Gmanmodz/RVL-Power-Management-System/Wii PMS BOM.xlsx

Wii Power Management System | Total: | 29.946
Reference | Description | Price | Manufacturer P/N | Vender | Link
U1, U2, U4, U5 | IC REG BUCK ADJ 4A SYNC 16QFN | 7.48 | TLV62095RGTR | Digikey | https://www.digikey.com/product-detail/en/texas-instruments/TLV62095RGTR/296-46277-1-ND/7033452
U3 | TPS61232DRCR | 2.54 | TPS61232DRCR | Digikey | https://www.digikey.com/product-detail/en/texas-instruments/TPS61232DRCR/296-44498-1-ND/6110782
U6 | IC MCU 8BIT 7KB FLASH 16UQFN | 0.85 | PIC16F15324T-I/JQ | Digikey | https://www.digikey.com/product-detail/en/microchip-technology/PIC16F15324T-I-JQ/PIC16F15324T-I-JQCT-ND/7346310
U7 | BQ25895M | 3.36 | BQ25895MRTWR | Digikey | https://www.digikey.com/products/en?keywords=296-42447-1-ND%09
R1, R2, R8, R9 | RES SMD 160K OHM 1% 1/10W 0603 | 0.4 | RC0603FR-07160KL | Digikey | https://www.digikey.com/product-detail/en/yageo/RC0603FR-07160KL/311-160KHRCT-ND/729920
R3 | RES SMD 44.2K OHM 1% 1/10W 0603 | 0.1 | RC0603FR-0744K2L | Digikey | https://www.digikey.com/product-detail/en/yageo/RC0603FR-0744K2L/311-44.2KHRCT-ND/730188
R4 | RES SMD 510K OHM 1% 1/10W 0603 | 0.1 | RC0603FR-07510KL | Digikey | https://www.digikey.com/product-detail/en/yageo/RC0603FR-07510KL/311-510KHRCT-ND/730233
R5, R7, R13, R15, R17, R18, R19 | RES SMD 10K OHM 1% 1/10W 0603 | 0.7 | RC0603FR-0710KL | Digikey | https://www.digikey.com/product-detail/en/yageo/RC0603FR-0710KL/311-10.0KHRCT-ND/729827
R6, R10, R14 | RES 100 OHM 1% 1/10W 0603 | 0.3 | RMCF0603FT100R | Digikey | https://www.digikey.com/product-detail/en/stackpole-electronics-inc/RMCF0603FT100R/RMCF0603FT100RCT-ND/1942965
R11 | RES SMD 200K OHM 1% 1/10W 0603 | 0.1 | RC0603FR-07200KL | Digikey | https://www.digikey.com/product-detail/en/yageo/RC0603FR-07200KL/311-200KHRCT-ND/729991
R12 | RES SMD 75K OHM 1% 1/10W 0603 | 0.1 | RC0603FR-0775KL | Digikey | https://www.digikey.com/product-detail/en/yageo/RC0603FR-0775KL/311-75.0KHRCT-ND/730325
R16 | RES SMD 261 OHM 1% 1/10W 0603 | 0.1 | RC0603FR-07261RL | Digikey | https://www.digikey.com/product-detail/en/yageo/RC0603FR-07261RL/311-261HRCT-ND/730042
RN1 | RES ARRAY 4 RES 10K OHM 0804 | 0.1 | EXB-28V103JX | Digikey | https://www.digikey.com/product-detail/en/panasonic-electronic-components/EXB-28V103JX/Y7103CT-ND/256360
C1, C2, C3, C4, C5, C6, C7, C10, C11, C12, C13, C14, C15, C16, C19, C20 | CAP CER 22UF 6.3V X5R 0805 | 2.336 | CL21A226MQQNNNE | Digikey | https://www.digikey.com/product-detail/en/samsung-electro-mechanics/CL21A226MQQNNNE/1276-1100-1-ND/3889186
C8, C9, C17, C18 | CAP CER 10000PF 50V X7R 0603 | 0.4 | 06035C103KAT4A | Digikey | https://www.digikey.com/product-detail/en/avx-corporation/06035C103KAT4A/478-10055-1-ND/6564278
C21, C22 | CAP CER 1UF 25V X7R 0805 | 0.76 | GCM21BR71E105KA56L | Digikey | https://www.digikey.com/product-detail/en/murata-electronics-north-america/GCM21BR71E105KA56L/490-4785-1-ND/1641704
C23 | CAP CER 4.7UF 16V X5R 0603 | 0.29 | CL10A475KO8NNNC | Digikey | https://www.digikey.com/product-detail/en/samsung-electro-mechanics/CL10A475KO8NNNC/1276-1784-1-ND/3889870
C24 | CAP CER 0.047UF 25V X7R 0603 | 0.13 | C0603C473K3RACTU | Digikey | https://www.digikey.com/product-detail/en/kemet/C0603C473K3RACTU/399-7931-1-ND/3471654
C25, C26, C27, C29 | CAP CER 10UF 16V X5R 0805 | 0.68 | CL21A106KOQNNNG | Digikey | https://www.digikey.com/product-detail/en/samsung-electro-mechanics/CL21A106KOQNNNG/1276-6455-1-ND/5958083
L1, L2, L3, L4, L5 | FIXED IND 1UH 5.1A 27 MOHM SMD | 3.6 | MDWK4040T1R0MM | Digikey | https://www.digikey.com/product-detail/en/taiyo-yuden/MDWK4040T1R0MM/587-4447-1-ND/5880037
L6 | FIXED IND 2.2UH 8A 20 MOHM SMD | 0.89 | ASPI-0630HI-2R2M-T15 | Digikey | https://www.digikey.com/product-detail/en/abracon-llc/ASPI-0630HI-2R2M-T15/ASPI-0630HI-2R2M-T15CT-ND/3060148
Q1, Q2, Q3 | TRANS NPN 40V 0.2A SOT23 | 0.3 | MMBT3904-TP | Digikey | https://www.digikey.com/product-detail/en/micro-commercial-co/MMBT3904-TP/MMBT3904TPMSCT-ND/717395
TH1 | THERMISTOR NTC 10KOHM 3988K BEAD | 3.72 | B57861S0103A043 | Digikey | https://www.digikey.com/product-detail/en/epcos-tdk/B57861S0103A043/495-6714-ND/4945323
RGB led | LED RGB DIFFUSED CHIP SMD | 0.61 | LTST-C19HE1WT | Digikey | https://www.digikey.com/products/en?keywords=160-2162-1
