Gmanmodz/RVL-Power-Management-System/RVLPMS (OLD)/WiiPMS KiCAD files/Wii reg.kicad_pcb

## KiCad design RVLPMS (OLD)/WiiPMS KiCAD files/Wii reg.kicad_pcb (2020-04-27, an earlier design)

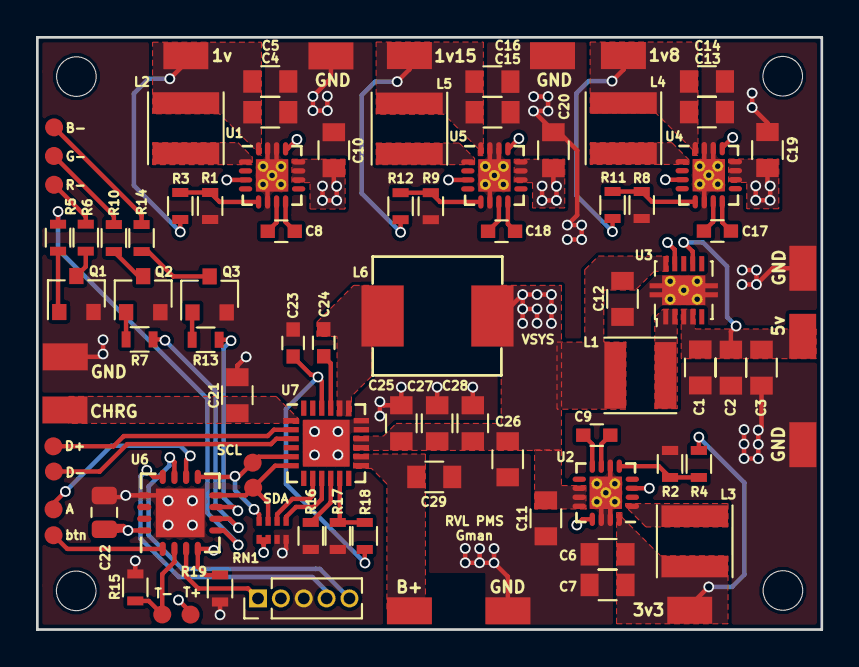
[picture p1: board Wii reg.kicad_pcb from above]

Board: 4 copper layers, 43.6 x 32.9 mm, 91 parts (0 on the bottom side), 56 nets.

Parts:
1v, 1v8, 1v15, 3v3, 5v: TEST_1P; TP2
B+: TEST_1P; TP2
C1, C2, C3, C4, C5, C6, C7, C10, C11, C12, C13, C14, C15, C16, C19, C20, C21, C25, C26, C27, C28, C29: C; C_0805
C8, C9, C17, C18, C23, C24: C; C_0603
C22: C; C_0805_2012Metric
CHRG: TEST_1P; TP2
GND: TEST_1P; TP2
GND#2, GND#3, GND#4, GND#5, GND#6: TEST_1P; TP2
J4, J5, J8, J11, J12, J14, J16, J17, J18, J24, J26: TEST_1P; TP1
J25: Conn_01x05; Pin_Header_Straight_1x05_Pitch1.27mm
L1, L2, L3, L4, L5: L; L_Taiyo-Yuden_MD-4040
L6: L; ASPI-0630HI-2R2M-T15
Q1, Q2, Q3: 2N3904; SOT-23_custom
R1, R2, R3, R4, R5, R6, R7, R8, R9, R10, R11, R12, R13, R14, R15, R16, R17, R18, R19: R; R_0603
RN1: R_Pack04; RA_0804
U1, U2, U4, U5: tlv62095; QFN-16-1EP_3x3mm_Pitch0.5mm_ThermalVias
U3: TPS61230; VSON-10-1EP_3x3mm_Pitch0.5mm_ThermalPad
U6: PIC16F15324; UQFN-16-1EP_4x4mm_Pitch0.65mm
U7: bq25895m; QFN-24-1EP_4x4mm_Pitch0.5mm
wREF**: MountingHole_2.2mm_M2

Connections:
1v: 1v.1, C4.1, C5.1, L2.1, R3.2, U1.16
1v8: 1v8.1, C13.1, C14.1, L4.1, R11.2, U4.16
1v15: 1v15.1, C15.1, C16.1, L5.1, R12.2, U5.16
3v3: 3v3.1, C6.1, C7.1, L3.1, R4.2, U2.16
5v: 5v.1, C1.1, C2.1, C3.1, U3.3, U3.4, U3.7
BLUE: R13.2, U6.7
CE: RN1.8, U7.9
EN: R19.1, U1.13, U2.13, U3.9, U4.13, U5.13, U6.4
GND: C1.2, C2.2, C3.2, C4.2, C5.2, C6.2, C7.2, C10.1, C11.1, C12.1, C13.2, C14.2, C15.2, C16.2, C19.1, C20.1, C21.1, C22.1, C23.1, C25.2, C26.1, C27.2, C28.2, C29.2, GND.1, GND#2.1, GND#3.1, GND#4.1, GND#5.1, GND#6.1, J25.3, Q1.1, Q2.1, Q3.1, R1.2, R2.2, R8.2, R9.2, R15.2, R16.2, R17.1, R19.2, RN1.1, RN1.2, U1.6, U1.14, U1.15, U1.17, U2.6, U2.14, U2.15, U2.17, U3.11, U4.6, U4.14, U4.15, U4.17, U5.6, U5.14, U5.15, U5.17, U6.13, U6.17, U7.17, U7.18, U7.25
GREEN: R7.1, U6.6
MCLR: J25.1, U6.3
unnamed: C8.1, U1.8
unnamed: C8.2, U1.7
unnamed: C9.1, U2.8
unnamed: C9.2, U2.7
unnamed: C17.1, U4.8
unnamed: C17.2, U4.7
unnamed: C18.1, U5.8
unnamed: C18.2, U5.7
unnamed: C21.2, CHRG.1, U7.1
unnamed: C24.1, L6.2, U7.19, U7.20
unnamed: C24.2, U7.21
unnamed: B+.1, C29.1, U7.13, U7.14
unnamed: J4.1, R6.1
unnamed: J5.1, R10.1
unnamed: J8.1, R14.1
unnamed: J17.1, U7.2
unnamed: J18.1, U7.3
unnamed: J24.1, U6.10
unnamed: J25.4, U6.12
unnamed: J25.5, U6.11
unnamed: L1.2, U3.1, U3.2
unnamed: L2.2, U1.1, U1.2
unnamed: L3.2, U2.1, U2.2
unnamed: L4.2, U4.1, U4.2
unnamed: L5.2, U5.1, U5.2
unnamed: Q1.2, R5.2
unnamed: Q1.3, R6.2
unnamed: Q2.2, R7.2
unnamed: Q2.3, R10.2
unnamed: Q3.2, R13.1
unnamed: Q3.3, R14.2
unnamed: R1.1, R3.1, U1.5
unnamed: R2.1, R4.1, U2.5
unnamed: R8.1, R11.1, U4.5
unnamed: R9.1, R12.1, U5.5
unnamed: R16.1, U7.10
unnamed: R17.2, R18.2, U7.11
OTG: RN1.7, U7.8
RED: R5.1, U6.5
REGN: C23.2, R18.1, U7.22
SCL: J14.1, RN1.5, U6.9, U7.5
SDA: J16.1, RN1.6, U6.8, U7.6
VSYS: C10.2, C11.2, C12.2, C19.2, C20.2, C22.2, C25.1, C26.2, C27.1, C28.1, J12.1, J25.2, L1.1, L6.1, RN1.3, RN1.4, U1.3, U1.10, U1.11, U1.12, U2.3, U2.10, U2.11, U2.12, U3.10, U4.3, U4.10, U4.11, U4.12, U5.3, U5.10, U5.11, U5.12, U6.16, U7.15, U7.16
Vtemp: J11.1, R15.1, U6.2
button: J26.1, U6.1
