Gmanmodz/RVL-Power-Management-System/RVL-PMS BOARD FILES/RVL-PMS HW2.kicad_pcb

## KiCad design RVL-PMS BOARD FILES/RVL-PMS HW2.kicad_pcb (2020-10-14)

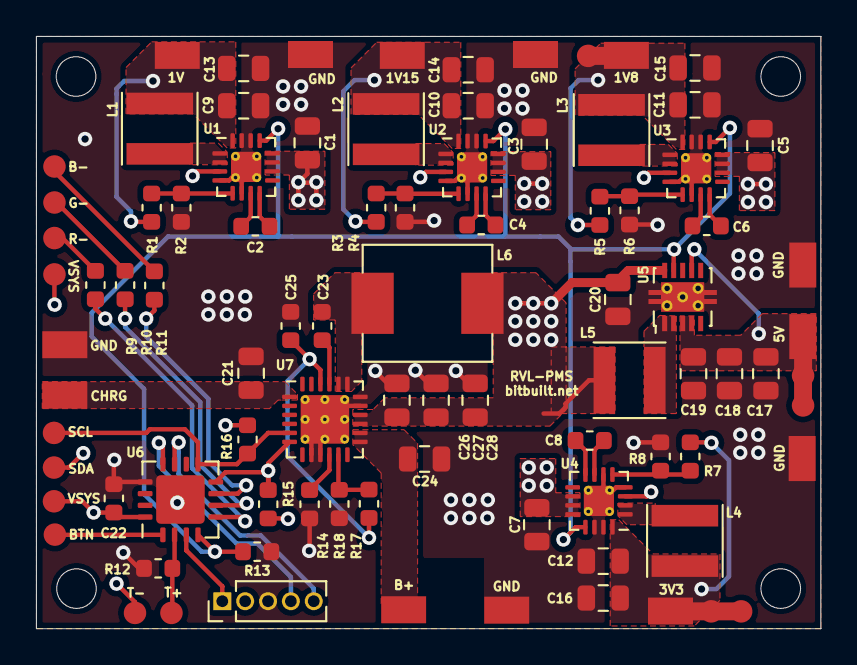
[picture p2: board RVL-PMS HW2.kicad_pcb from above]

Board: 4 copper layers, 43.6 x 32.9 mm, 88 parts (0 on the bottom side), 45 nets.

Parts:
C1, C3, C5, C7, C9, C10, C11, C12, C13, C14, C15, C16, C17, C18, C19, C20, C21, C24, C26, C27, C28: C; C_0805_2012Metric
C2, C4, C6, C8, C22, C23, C25: C; C_0603_1608Metric
J1: Conn_01x05_Female; PinHeader_1x05_P1.27mm_Vertical
L1, L2, L3, L4, L5: L; L_Taiyo-Yuden_MD-4040
L6: L; ASPI-0630HI-2R2M-T15
R1, R2, R3, R4, R5, R6, R7, R8, R9, R10, R11, R12, R13, R14, R15, R16, R17, R18: R; R_0603_1608Metric
TP1, TP2, TP3, TP4, TP5, TP6, TP7, TP9, TP11, TP15, TP19, TP20, TP21: TestPoint; Voltage_pad
TP8, TP10, TP12, TP13, TP14, TP16, TP17, TP18, TP22, TP23, TP24, TP25, TP26, TP27, TP28: TestPoint; 1.25mm pad
U1, U2, U3, U4: TLV62095RGTx; VQFN-16-1EP_3x3mm_P0.5mm_EP1.68x1.68mm_ThermalVias
U5: Wii_reg-cache_Wii-reg-rescue_TPS61230-tps61230; VSON-10-1EP_3x3mm_P0.5mm_EP1.65x2.4mm_ThermalVias
U6: Wii_reg-cache_pic16f15324_PIC16F15324; QFN-16-1EP_4x4mm_P0.65mm_EP2.7x2.7mm
U7: BQ25895RTW; Texas_S-PWQFN-N24_EP2.7x2.7mm_ThermalVias

Connections:
3V3: C12.1, C16.2, L4.1, R7.2, TP4.1, TP24.1, TP25.1, U4.16
5V: C17.1, C18.1, C19.1, TP5.1, TP26.1, TP27.1, U5.3, U5.4, U5.7
AGND: C1.2, C3.2, C5.2, C7.2, C9.2, C10.2, C11.2, C12.2, C13.1, C14.1, C15.1, C16.1, C17.2, C18.2, C19.2, C20.1, C21.2, C22.1, C24.1, C25.1, C26.2, C27.2, C28.2, J1.3, R2.2, R4.2, R6.2, R8.2, R12.2, R13.2, R14.2, R18.1, TP6.1, TP7.1, TP9.1, TP11.1, TP20.1, TP21.1, U1.4, U1.6, U1.14, U1.15, U1.17, U2.4, U2.6, U2.14, U2.15, U2.17, U3.4, U3.6, U3.14, U3.15, U3.17, U4.4, U4.6, U4.14, U4.15, U4.17, U5.11, U6.13, U6.17, U7.8, U7.9, U7.17, U7.18, U7.25
B: R11.2, U6.7
EN: R13.1, U1.13, U2.13, U3.13, U4.13, U5.9, U6.4
G: R10.2, U6.6
MCLR: J1.1, U6.3
unnamed: C2.1, U1.7
unnamed: C2.2, U1.8
unnamed: C4.1, U2.7
unnamed: C4.2, U2.8
unnamed: C6.1, U3.7
unnamed: C6.2, U3.8
unnamed: C8.1, U4.7
unnamed: C8.2, U4.8
unnamed: C10.1, C14.2, L2.1, R3.2, TP2.1, U2.16
unnamed: C11.1, C15.2, L3.1, R5.2, TP3.1, TP28.1, U3.16
unnamed: C9.1, C13.2, L1.1, R1.2, TP1.1, U1.16
unnamed: C21.1, TP15.1, U7.1
unnamed: C23.1, U7.21
unnamed: C23.2, L6.2, U7.19, U7.20
unnamed: C24.2, TP19.1, U7.13, U7.14
unnamed: C25.2, R17.2, U7.22
unnamed: J1.4, U6.12
unnamed: J1.5, U6.11
unnamed: L1.2, U1.1, U1.2
unnamed: L2.2, U2.1, U2.2
unnamed: L3.2, U3.1, U3.2
unnamed: L4.2, U4.1, U4.2
unnamed: L5.2, U5.1, U5.2
unnamed: R1.1, R2.1, U1.5
unnamed: R3.1, R4.1, U2.5
unnamed: R5.1, R6.1, U3.5
unnamed: R7.1, R8.1, U4.5
unnamed: R9.1, TP8.1
unnamed: R10.1, TP10.1
unnamed: R11.1, TP12.1
unnamed: R14.1, U7.10
unnamed: R17.1, R18.2, U7.11
R: R9.2, U6.5
SCL: R16.1, TP18.1, U6.9, U7.5
SDA: R15.2, TP17.1, U6.8, U7.6
VSYS: C1.1, C3.1, C5.1, C7.1, C20.2, C22.2, C26.1, C27.1, C28.1, J1.2, L5.1, L6.1, R15.1, R16.2, TP16.1, TP22.1, TP23.1, U1.3, U1.10, U1.11, U1.12, U2.3, U2.10, U2.11, U2.12, U3.3, U3.10, U3.11, U3.12, U4.3, U4.10, U4.11, U4.12, U5.10, U6.16, U7.15, U7.16
VTEMP: R12.1, TP14.1, U6.2
btn: TP13.1, U6.1
