Gmanmodz/RVL-Power-Management-System/RGB LED pcb/RGB LED pcb.kicad_pcb

## KiCad design RGB LED pcb/RGB LED pcb.kicad_pcb (2019-10-02)

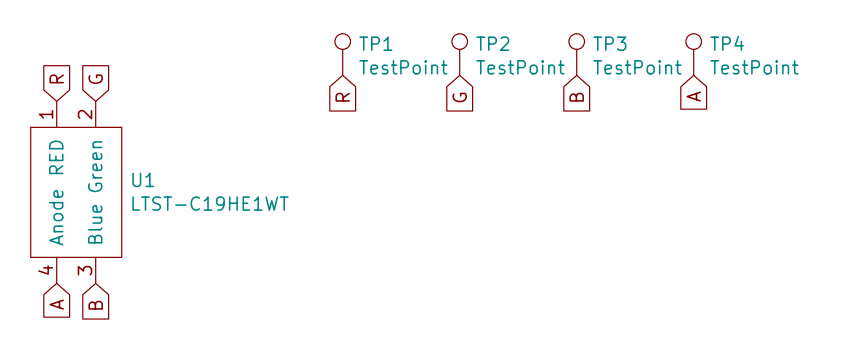
[picture p3: schematic RGB LED pcb.sch]

Parts:
TP1, TP2, TP3, TP4: TestPoint; 1.25mm pad
U1: LTST-C19HE1WT

Connections:
A: TP4.1, U1.4 (Anode)
B: TP3.1, U1.3 (Blue)
G: TP2.1, U1.2 (Green)
R: TP1.1, U1.1 (RED)

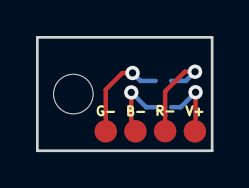
[picture p4: board RGB LED pcb.kicad_pcb from above]

Board: 2 copper layers, 9.7 x 6.3 mm, 5 parts (1 on the bottom side), 4 nets.
