Gmanmodz/RVL-Power-Management-System/RVLPMS_FIRMWARE/main.c

/*
 * File:   main.c
 * Author: Gunnar
 *
 * Created on September 13, 2019, 9:32 PM
 */

#include <xc.h>
#include <stdint.h>
#include <pic16f15324.h>
#include "PICCONFIG.h"
#include "PWM.h"
#include "PPS.h"
#include "I2C.h"
#include "BQ25895M.h"
#include "ADC.h"
#include "LED_INTERFACE.h"
#include "stusb4500.h"
#include "time.h"

void PIC_SETUP(){
    
    CPUDOZEbits.IDLEN = 0;      //clear idle mode
    VREGCON = 0b00000011;       //low power sleep mode
    
    //IO setup
    TRISA = 0xFF;
    TRISC = 0xFF;
    ANSELA = 0;
    ANSELC = 0;
    ANSELAbits.ANSA4 = 1;   //thermistor
    WPUA = 0b00100000;      //WPU on RA5 BTN
    
    //TIMER1 setup
    T1CONbits.CKPS = 0b00;  //1:1 prescale
    T1CONbits.nSYNC = 0;
    T1CONbits.RD16 = 1;     //16-bit read
    T1GCONbits.GE = 0;      //Gate OFF
    T1CLK = 0b00000100;     //CLK is LFINTOSC
    TMR1 = TMR1_RST;  
    PIE4bits.TMR1IE = 1;    //enable tmr1 interrupt     
    T1CONbits.ON = 1;
    
    //IOC setup
    PIE0bits.IOCIE = 1;     //enable IOC module
    IOCAP = 0b00100000;     //PSEDGE enable bits
    IOCAN = 0b00100000;     //NEGEDGE enable bits
    IOCAF = 0x00;
    
    INTCONbits.GIE = 1;     //enable active interrupts
    INTCONbits.PEIE = 1;    //enable peripheral interrupts
}

uint8_t SYS_ENABLE = 0;         //regulator enable state
uint32_t btn_time_start = 0;    //timer for debouncing button
uint8_t pwr_btn_temp = 0;
uint8_t pwr_btn_temp_prev = 0;
uint8_t btn_state = 0;  //0: not pressed 1: being debounced 2: pressed
uint32_t btn_time_pressed = 0;  //timer for how long button has been held
uint8_t btn_high_edge = 1;      //goes high when button is released
uint8_t btn_press_count = 0;    //how many times button has been pressed in short time interval
uint32_t btn_press_timer = 0;   //timer for determining double press
uint8_t btn_long_edge = 0;  //goes high when btn is long press, resets when btn is released

uint8_t set_stusb4500 = 0;
uint32_t stusb4500_timeout = 0;

void interrupt ISR(){

    if(TMR1IF) {
        TMR1IF = 0;
        TMR1 = TMR1_RST;
        timer_counter++;
    }
    
    if(IOCAF5) {
        IOCAF5 = 0;
    }
    
} 

void thermal_protection(){    
    //calculating setpoint = 255 / [(Therm_resistance(at temp) / 10,000 ) + 1]
    //For temp = 75C, setpoint = 222
    if(readADC(ADCRA4) >= 222) {
        SYS_ENABLE = 0;
        TRISCbits.TRISC5 = 1;       //turn off regulators
        BQ_Write(0x09, 0b01100100); //Force BATFET off 
    }    
}

void ps2_on() {
    //turn on ps2
    __delay_ms(1200);
    TRISAbits.TRISA2 = 0;   //ps2 reset output
    aux = 0;                //ps2 reset low
    __delay_ms(200);
    TRISAbits.TRISA2 = 1;   //ps2 reset float 
}

void main() {
            
    PIC_SETUP();
    
    //clear i2c bus if SDA held low
    I2C_bus_reset();
    
    //Initialize I2C Master
    PPS_unlock();
    SSP1DATPPS = 0x11;  //SDA INPUT
    RC1PPS = 0x16;      //SDA OUTPUT
    SSP1CLKPPS = 0x10;  //SDA INPUT
    RC0PPS = 0x15;      //SCL OUTPUT
    PPS_lock();
    I2C_Master_Init(350000);   
    
    BQ_CONFIG_INIT();
    BQ_INIT();
    
    PWM_INIT();

    while(1) {

        CLRWDT();
        
        //debouncing the power button
        pwr_btn_temp = pwr_btn;
        if(pwr_btn_temp ^ pwr_btn_temp_prev) {  //if curr/prev values are not equal, then it is not debounced
            btn_time_start = get_time();
            btn_state = 1;
        }  
        if(timer_diff(btn_time_start) > 4) {
            if(!pwr_btn_temp) { //btn is pressed, on first edge, grab the time
                if(btn_state != 2) btn_time_pressed = get_time();
                btn_state = 2;      
            }
            else {   //btn is not pressed
                btn_state = 0;
            }
        }
        pwr_btn_temp_prev = pwr_btn_temp;
             
        //power_button state machine
        if(btn_state == 2) {
            if(timer_diff(btn_time_pressed) > 84 && btn_long_edge == 0) {
                SYS_ENABLE = !SYS_ENABLE;
                if(SYS_ENABLE) {
                    TRISCbits.TRISC5 = 0;
                    enable = 1;                     //turn on regulators   
                    //ps2_on();
                }
                else {
                    TRISCbits.TRISC5 = 1;           //turn off regulators
                    if(mode == 3) {                 //shipping mode
                        BQ_Write(0x09, 0b01100100); //Force BATFET off 
                    }
                }
                btn_long_edge = 1;
            }
            btn_high_edge = 0;
        }
        if(btn_state == 0) {
            if(btn_high_edge == 0) {
                if(SYS_ENABLE && timer_diff(btn_time_pressed)<=50){ //short press
                    if(btn_press_count == 0) btn_press_timer = get_time();
                    btn_press_count++;
                    if(btn_press_count == 2) {  //double press
                        if(!VBUS_CHRG_STATE[1]) mode++; //only increment mode when not charging
                    }                    
                }
            }
            btn_high_edge = 1;
            btn_long_edge = 0;
        }
        if(timer_diff(btn_press_timer) > 50) btn_press_count = 0;   //reset double press counter
        
        BQ_UPDATE();
        thermal_protection();
                   
        //if battery is low, revert to mode 2 to warn user
        //.02V/bit, 2.304V offset. bit value = [(desired cutoff voltage) - 2.304] / .02V/bit
        if(BATTERY_VOLTAGE <= 50) mode = 2;
        
        //setting the led interface
        if(VBUS_CHRG_STATE[1] == 0) {
            if(SYS_ENABLE) {
                led_modes();
            }
            if(timer_diff(stusb4500_timeout) >= 500) {
                set_stusb4500 = 0;
            }
        }
        else {
            chrg_led();
            if(!set_stusb4500) {
                stusb_negotiate();
                set_stusb4500 = 1;
                stusb4500_timeout = get_time();           
            }
        }
        
        //power consumption putting pic to sleep
        if(!SYS_ENABLE && VBUS_CHRG_STATE[1]==0 && btn_state==0 && BQ_adc_state==0 && !set_stusb4500) {
            PWM_power_down();
            CLRWDT();
            SLEEP();    
            RESET();
        }
        
    }  
}
