Gmanmodz/RVL-Power-Management-System/RVLPMS_FIRMWARE/stusb4500.c

//library by Jeff Longo

#include "stusb4500.h"

#include "i2c_driver_stusb4500.h"
#include "PICCONFIG.h"

#include <stdint.h>
#include <xc.h>

// STUSB4500 i2c address
#define STUSB_ADDR 0x28

// STUSB4500 registers
#define PORT_STATUS 0x0E
#define PRT_STATUS 0x16
#define CMD_CTRL 0x1A
#define RESET_CTRL 0x23
#define WHO_AM_I 0x2F
#define RX_BYTE_CNT 0x30
#define RX_HEADER 0x31
#define RX_DATA_OBJ 0x33
#define TX_HEADER 0x51
#define DPM_SNK_PDO1 0x85

// STUSB4500 masks
#define DEVICE_ID 0x25
#define DEVICE_ID_B 0x21
#define SW_RESET_ON 0x01
#define SW_RESET_OFF 0x00
#define ATTACH 0x01
#define PRT_MESSAGE_RECEIVED 0x04
#define SRC_CAPABILITIES_MSG 0x01

// PD protocol commands, see USB PD spec Table 6-3
#define PD_CMD 0x26
#define PD_GET_SRC_CAP 0x0007
#define PD_SOFT_RESET 0x000D

// See USB PD spec Table 6-1
#ifdef USBPD_REV30_SUPPORT
#define HEADER_MESSAGE_TYPE(header) (header & 0x1F)
#else // USBPD_REV30_SUPPORT
#define HEADER_MESSAGE_TYPE(header) (header & 0x0F)
#endif // USBPD_REV30_SUPPORT
#define HEADER_NUM_DATA_OBJECTS(header) ((header >> 12) & 0x07)

// See USB PD spec Section 7.1.3 and STUSB4500 Section 5.2 Table 16
#define PDO_TYPE(pdo) ((pdo >> 30) & 0x03)
#define PDO_TYPE_FIXED 0x00
#define FROM_PDO_CURRENT(pdo) ((pdo & 0x03FF) * 10)
#define FROM_PDO_VOLTAGE(pdo) (((pdo >> 10) & 0x03FF) * 50)
#define TO_PDO_CURRENT(mA) ((mA / 10) & 0x03FF)
#define TO_PDO_VOLTAGE(mV) ((uint32_t)((mV / 50) & 0x03FF) << 10)

// TODO: This doesn't work
static int send_pd_message(const uint16_t msg) {
    int ok = I2C_OK;

    if (ok) ok = i2c_master_write_u16(STUSB_ADDR, TX_HEADER, msg);
    if (ok) ok = i2c_master_write_u8(STUSB_ADDR, CMD_CTRL, PD_CMD);

    return (ok == I2C_OK) ? STUSB_OK : STUSB_FAILURE;
}

static int reset(void) {
    int ok = I2C_OK;

    // Enable software reset
    if (ok == I2C_OK)
        ok = i2c_master_write_u8(STUSB_ADDR, RESET_CTRL, SW_RESET_ON);

    // Wait for stusb to respond
    if (ok == I2C_OK) {
        uint8_t res;
        do {
            ok = i2c_master_read_u8(STUSB_ADDR, WHO_AM_I, &res);
        } while (ok == I2C_OK && res != DEVICE_ID && res != DEVICE_ID_B);
    }

    // TODO: Necessary? Wait for source to be ready
    if (ok == I2C_OK) __delay_ms(27);

    // Disable software reset
    if (ok == I2C_OK)
        ok = i2c_master_write_u8(STUSB_ADDR, RESET_CTRL, SW_RESET_OFF);

    return (ok == I2C_OK) ? STUSB_OK : STUSB_FAILURE;
}

static int
  write_pdo(uint16_t current_mA, uint16_t voltage_mV, uint8_t pdo_num) {
    if (pdo_num < 1 || pdo_num > 3) return STUSB_FAILURE;

    // Format the sink PDO
    uint32_t pdo =
      0x00000000 | TO_PDO_CURRENT(current_mA) | TO_PDO_VOLTAGE(voltage_mV);

    // Write the sink PDO
    if (
      i2c_master_write_u32(STUSB_ADDR, DPM_SNK_PDO1 + 4 * (pdo_num - 1), pdo) !=
      I2C_OK)
        return STUSB_FAILURE;

    // Force a renegotiation
    return reset();
}

static int negotiate_optimal_pdo(uint32_t* src_pdos, uint8_t num_pdos) {
    int ok = STUSB_FAILURE;

    uint16_t opt_pdo_current = 0;
    uint16_t opt_pdo_voltage = 0;
    uint32_t opt_pdo_power = 0;

    // Search for the optimal PDO, if any
    for (int i = 0; i < num_pdos; i++) {
        uint32_t pdo = src_pdos[i];

        // Extract PDO parameters
        uint16_t pdo_current = FROM_PDO_CURRENT(pdo);
        uint16_t pdo_voltage = FROM_PDO_VOLTAGE(pdo);
        uint32_t pdo_power = (uint32_t)pdo_current * pdo_voltage / 1000;

        if (
          PDO_TYPE(pdo) != PDO_TYPE_FIXED || pdo_current < PDO_CURRENT_MIN ||
          pdo_voltage < PDO_VOLTAGE_MIN || pdo_voltage > PDO_VOLTAGE_MAX)
            continue;
        if (pdo_power > opt_pdo_power) {
            opt_pdo_current = pdo_current;
            opt_pdo_voltage = pdo_voltage;
            opt_pdo_power = pdo_power;
            ok = STUSB_OK;
        }
    }

    // Push the new PDO
    if (ok == STUSB_OK) ok = write_pdo(opt_pdo_current, opt_pdo_voltage, 3);

    return ok;
}

int stusb_negotiate(void) {
    uint8_t buffer[40];
    uint16_t header;

    // Check if cable attached
    if (
      i2c_master_read_u8(STUSB_ADDR, PORT_STATUS, buffer) != I2C_OK ||
      !(buffer[0] & ATTACH))
        return STUSB_FAILURE;

    // Soft reset to force source capabilities message transmission
    if (reset() != STUSB_OK) return STUSB_FAILURE;

    while (1) {
        // Read the port status to look for a source capabilities message
        if (i2c_master_read_u8(STUSB_ADDR, PRT_STATUS, buffer) != I2C_OK)
            return STUSB_FAILURE;

        // Message has not arrived yet
        if (!(buffer[0] & PRT_MESSAGE_RECEIVED)) continue;

        // Read message header
        if (i2c_master_read_u16(STUSB_ADDR, RX_HEADER, &header) != I2C_OK)
            return STUSB_FAILURE;

        // Not a data/source capabilities message, continue waiting
        if (
          !HEADER_NUM_DATA_OBJECTS(header) ||
          HEADER_MESSAGE_TYPE(header) != SRC_CAPABILITIES_MSG)
            continue;

        // Read number of received bytes
        if (i2c_master_read_u8(STUSB_ADDR, RX_BYTE_CNT, buffer) != I2C_OK)
            return STUSB_FAILURE;

        // Check for missing data
        if (buffer[0] != HEADER_NUM_DATA_OBJECTS(header) * 4)
            return STUSB_FAILURE;

        break;
    }

    // Read source capabilities
    // WARNING: This must happen very soon after the previous code block is
    // executed. The source will send an accept message which partially
    // overwrites the source capabilities message. Use i2c clock >= 300 kHz
    if (
      i2c_master_read(
        STUSB_ADDR, RX_DATA_OBJ, buffer, HEADER_NUM_DATA_OBJECTS(header) * 4) !=
      I2C_OK)
        return STUSB_FAILURE;

    // Find and negotiate the optimal PDO, if any
    return negotiate_optimal_pdo(
      (uint32_t*)buffer, HEADER_NUM_DATA_OBJECTS(header));
}
