Gmanmodz/RVL-Power-Management-System/RVLPMS_FIRMWARE/PWM.h

/* 
 * File:   PWM.h
 * Author: Gunnar T
 * Comments:
 * Revision history: 
 */
 
#ifndef PWM_H
#define	PWM_H

#include <xc.h> // include processor files - each processor file is guarded. 

void PWM_INIT();
void PWM_power_down();

#endif	
