Gmanmodz/RVL-Power-Management-System/RVLPMS_FIRMWARE/PPS.h

/* 
 * File:   PPS.h
 * Author: Gunnar T
 * Comments:
 * Revision history: 
 */
 
#ifndef PPS_H
#define	PPS_H

#include <xc.h> // include processor files - each processor file is guarded. 

void PPS_unlock();
void PPS_lock();

#endif	
