Gmanmodz/RVL-Power-Management-System/(commit log)

2019-03-18 Update Wii PMS BOM.xlsx
    Fixed row 9 part#
    [Wii PMS BOM.xlsx]
2019-03-21 update 1
    changed some mode logic. Made a distinction between low battery and charging.
2019-10-02 WiiPMS firmware v2
    Rewrote the project to use new features including powered off charging indicator and using jeff's dynamic pd source negotation library.
    [RGB LED pcb.kicad_pcb, Wii reg-2018-08-30-21-59-42.sch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]
2020-04-27 Added STUSB DEVICE_ID_B for compatibility with USBCBoard
    [Wii reg.kicad_pcb]
2020-10-14 Updated new board files and code
    This new code is not to be used on the older PMS boards. I deleted the transistor LED drivers because they weren't needed and the code now has inverted the LED outputs.
    [RVL-PMS HW2-B_Cu.gbr, RVL-PMS HW2-B_Mask.gbr, RVL-PMS HW2-B_Paste.gbr, RVL-PMS HW2-B_SilkS.gbr, RVL-PMS HW2-Edge_Cuts.gbr, RVL-PMS HW2-F_Cu.gbr, RVL-PMS HW2-F_Mask.gbr, RVL-PMS HW2-F_Paste.gbr]
2020-11-28 fixed mistake in chrg_timer variable
    [BQ25895M.c]
